bowrango/ising-machine-app/hardware/schematic/sync-ground-bounce-scope.jpg

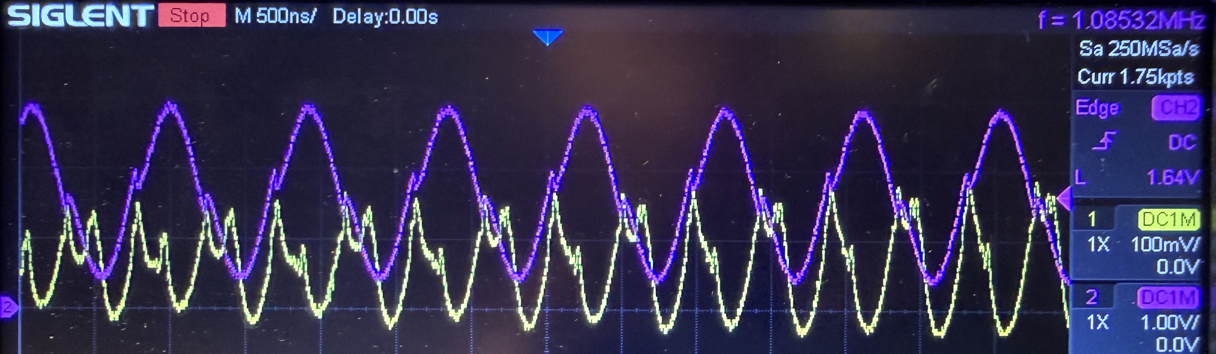
hardware/schematic/sync-ground-bounce-scope.jpg
