bowrango/ising-machine-app/hardware/schematic/software-overview.pdf

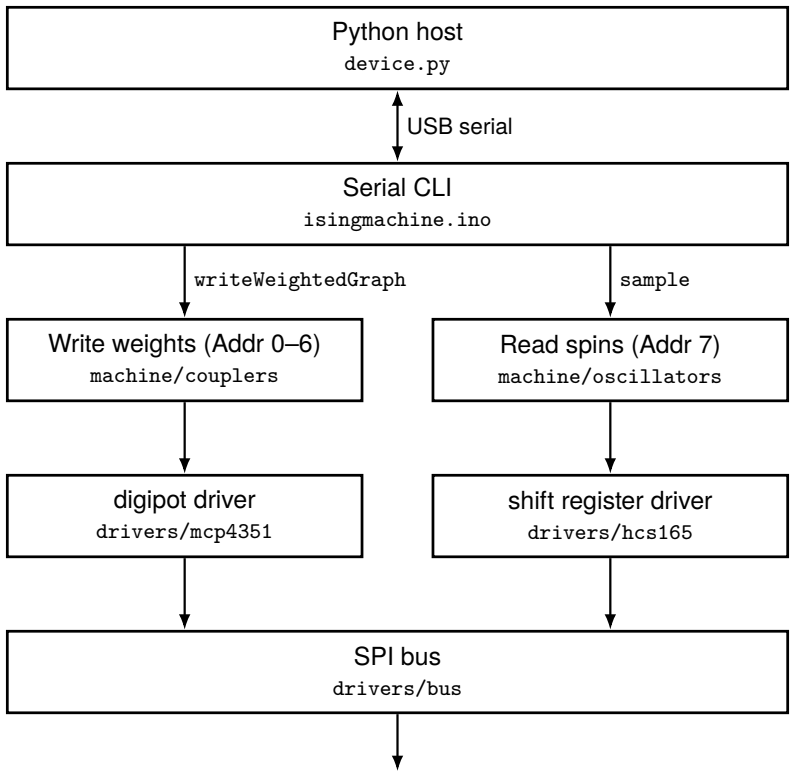
[picture p2: figure]
Python host device.py; Serial CLI isingmachine.ino; USB serial; Write weights (Addr 0–6) machine/couplers; Read spins (Addr 7) machine/oscillators; writeWeightedGraph; sample; digipot driver drivers/mcp4351; shift register driver drivers/hcs165; SPI bus drivers/bus

ADDR, CS1, SH/LD, SCLK, MOSI, MISO
