bowrango/ising-machine-app/hardware/schematic/system-overview.pdf

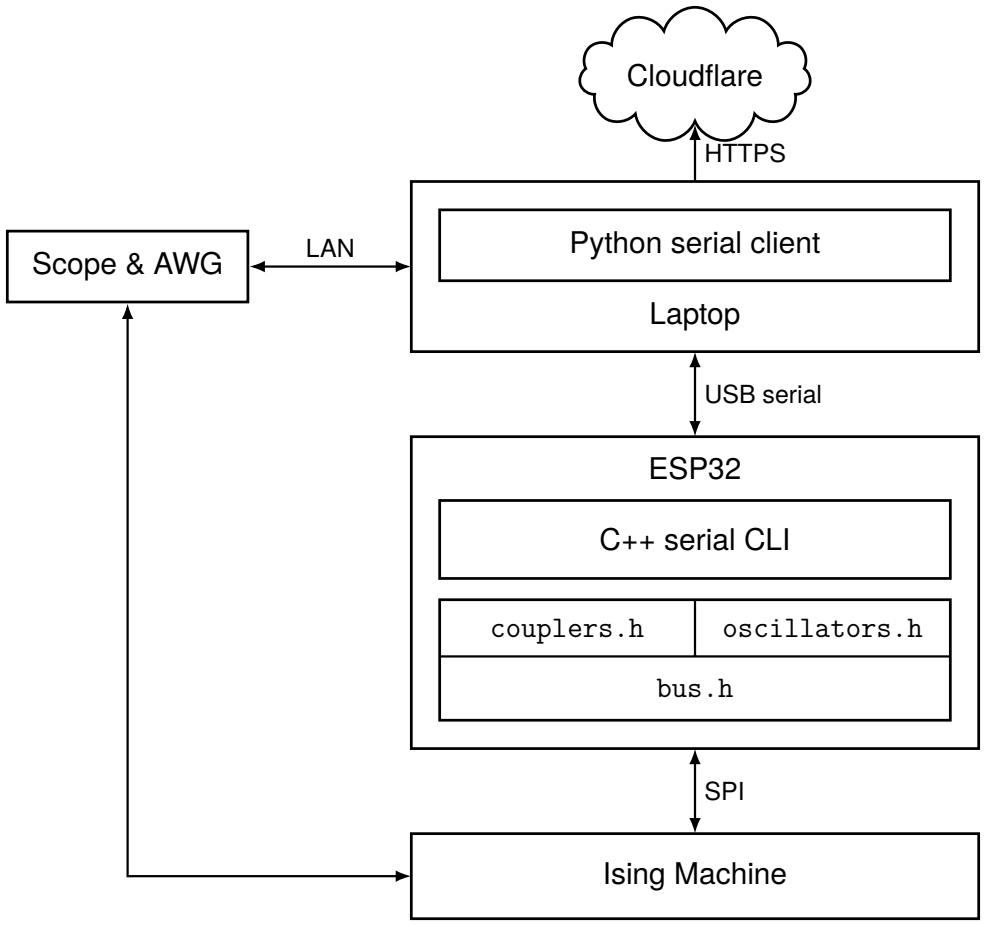
[picture p3: figure]
Cloudflare; Python serial client; Laptop; HTTPS; Scope & AWG; LAN; ESP32; C++ serial CLI; couplers.h; oscillators.h; bus.h; USB serial; Ising Machine; SPI
