bowrango/ising-machine-app/hardware/schematic/cloudflare.pdf

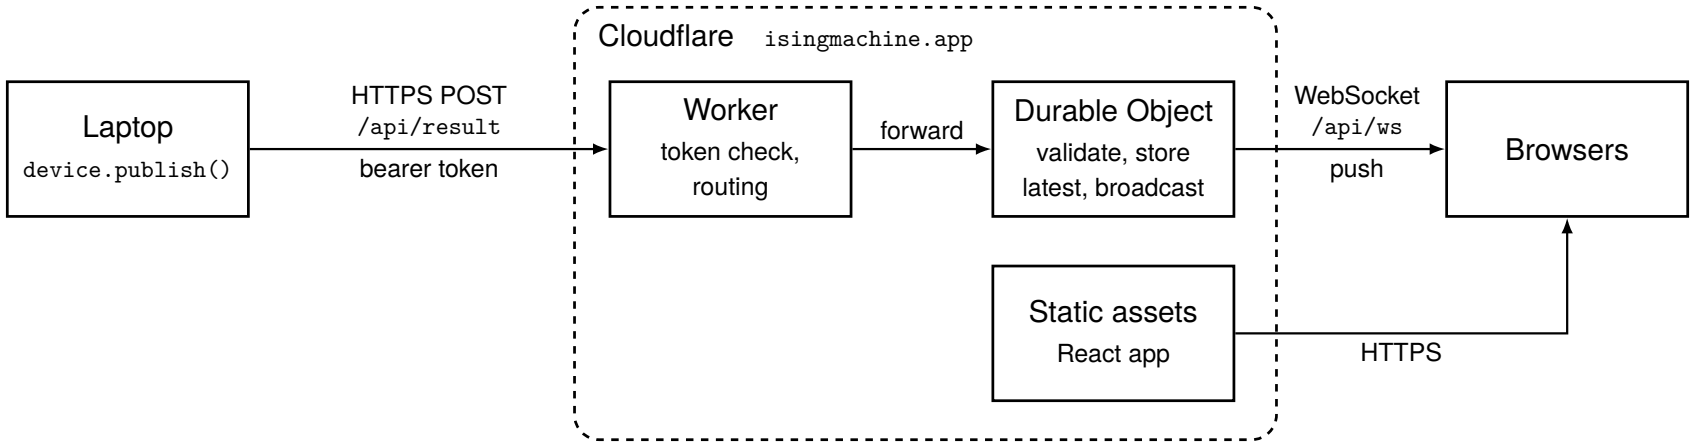
[picture p4: figure]
Cloudflare isingmachine.app; Laptop device.publish(); Worker token check, routing; Durable Object validate, store latest, broadcast; Static assets React app; Browsers; HTTPS POST /api/result bearer token; forward; WebSocket /api/ws push; HTTPS
