bowrango/ising-machine-app/hardware/schematic/spi-bus.pdf

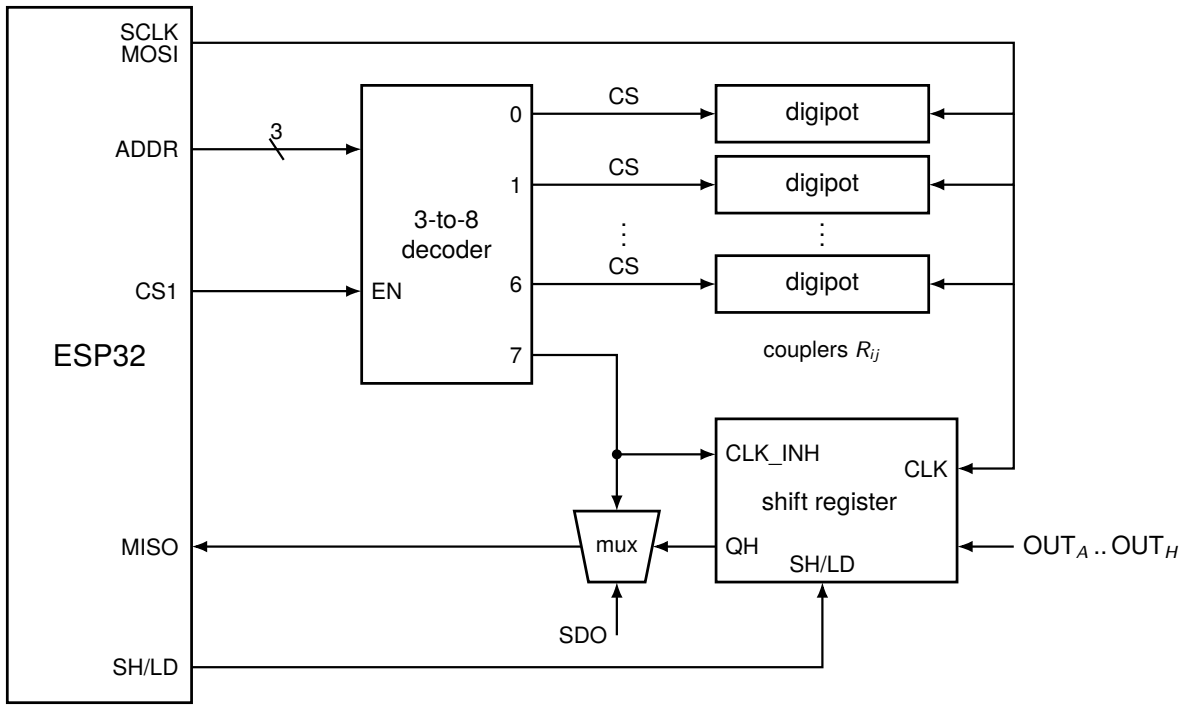
[picture p5: figure]
ESP32; SCLK MOSI; ADDR; MISO; shift register; CLK; 3-to-8 decoder; digipot; couplers Rij; CLK_INH; OUTA .. OUTH; mux; SDO
