bowrango/ising-machine-app/hardware/schematic/coupling-network.pdf

## Problem matrix

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
QUBO Q ∼ 1/R
8 variables
28 possible terms (no bias)

## Conductance matrix

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
Pattern symmetric about the anti-diagonal Coupled at opposite terminals

## Digipot network

A_L (5) | A_R (6)
B_L (9) | B_R (10)
C_L (11) | C_R (12)
D_L (7) | D_R (8)
E_L (1) | E_R (2)
F_L (13) | F_R (14)
G_L (15) | G_R (16)
H_L (3) | H_R (4)

L R

7 × 4-channel digital potentiometers (10 kΩ, 8-bit) Program Rij (8-bit)
