bowrango/ising-machine-app/hardware/schematic/cloudflare.png

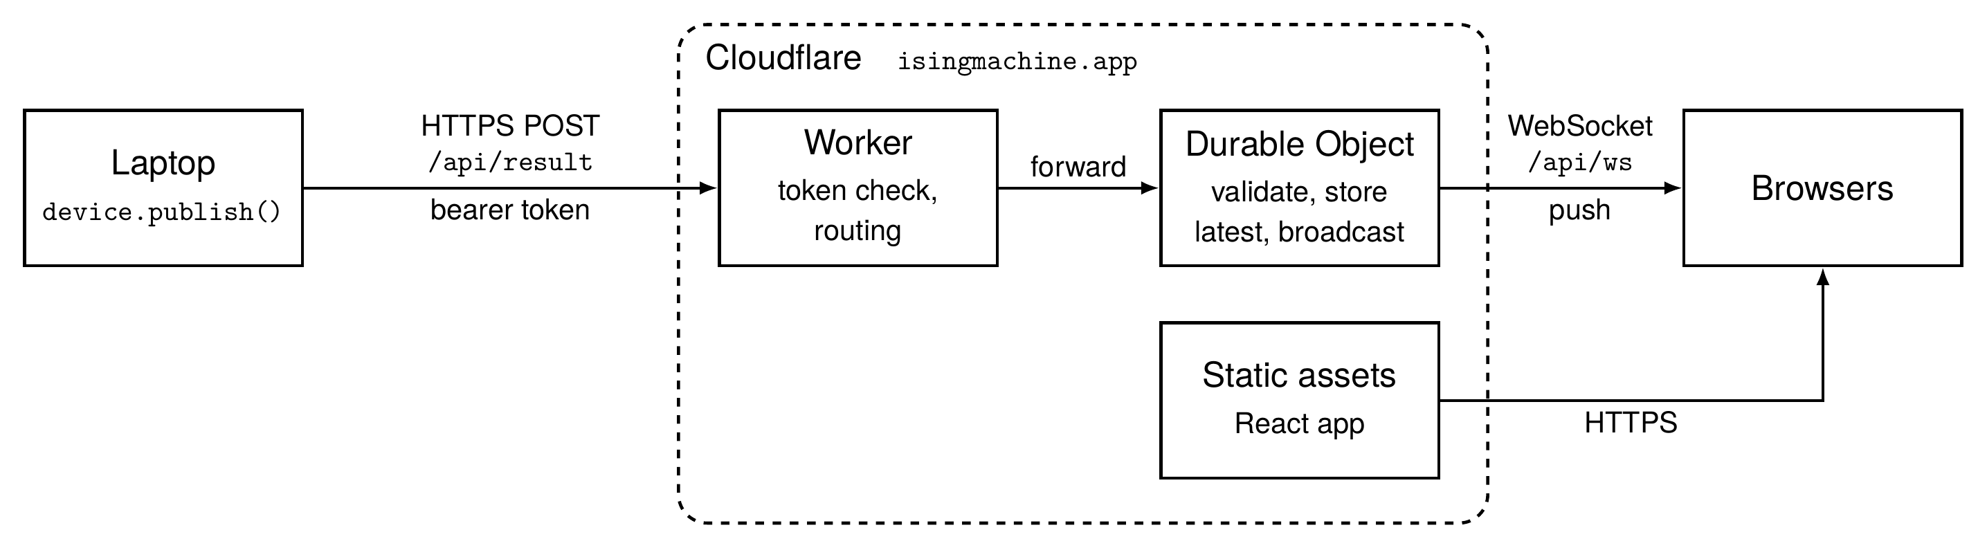
hardware/schematic/cloudflare.png
