bowrango/ising-machine-app/hardware/schematic/coupling-network.png

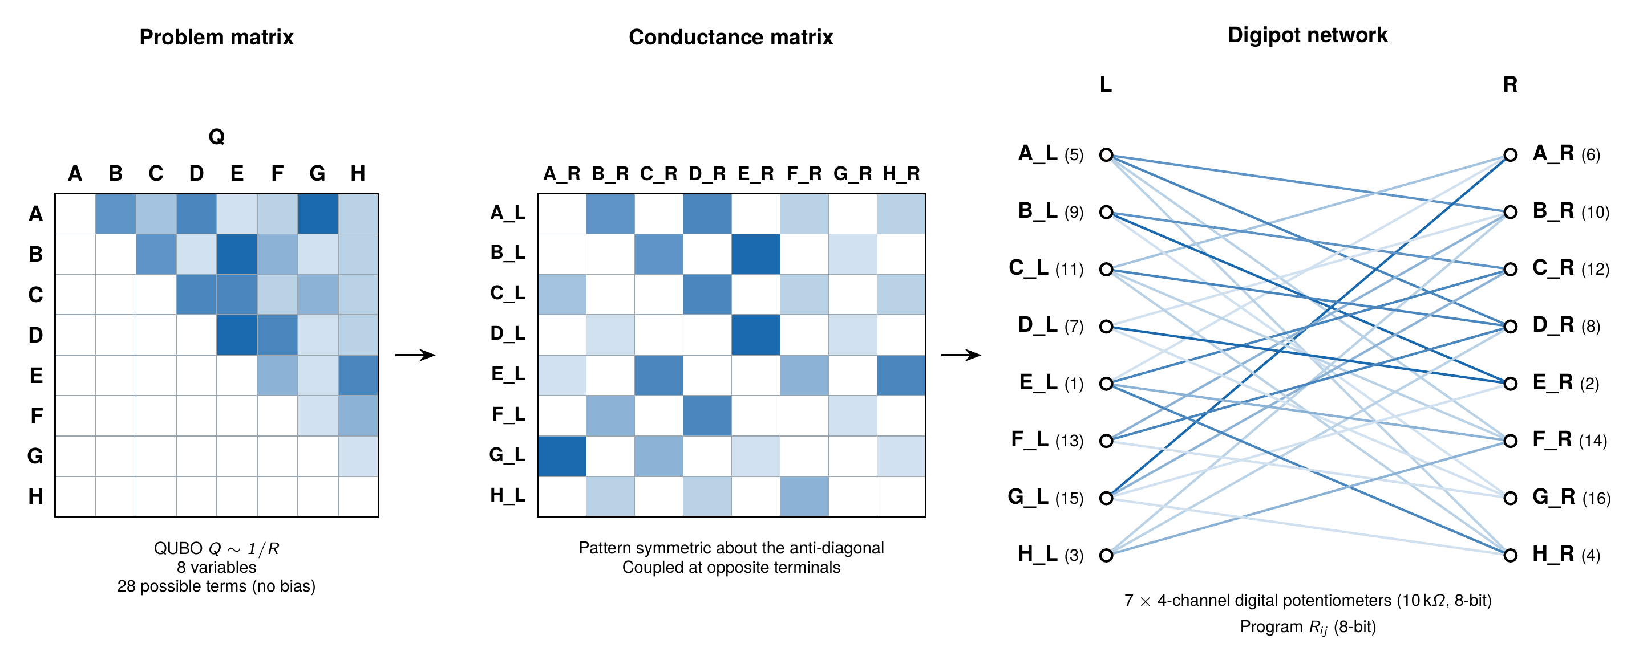
hardware/schematic/coupling-network.png
