bowrango/ising-machine-app/hardware/schematic/oscillator-connection.png

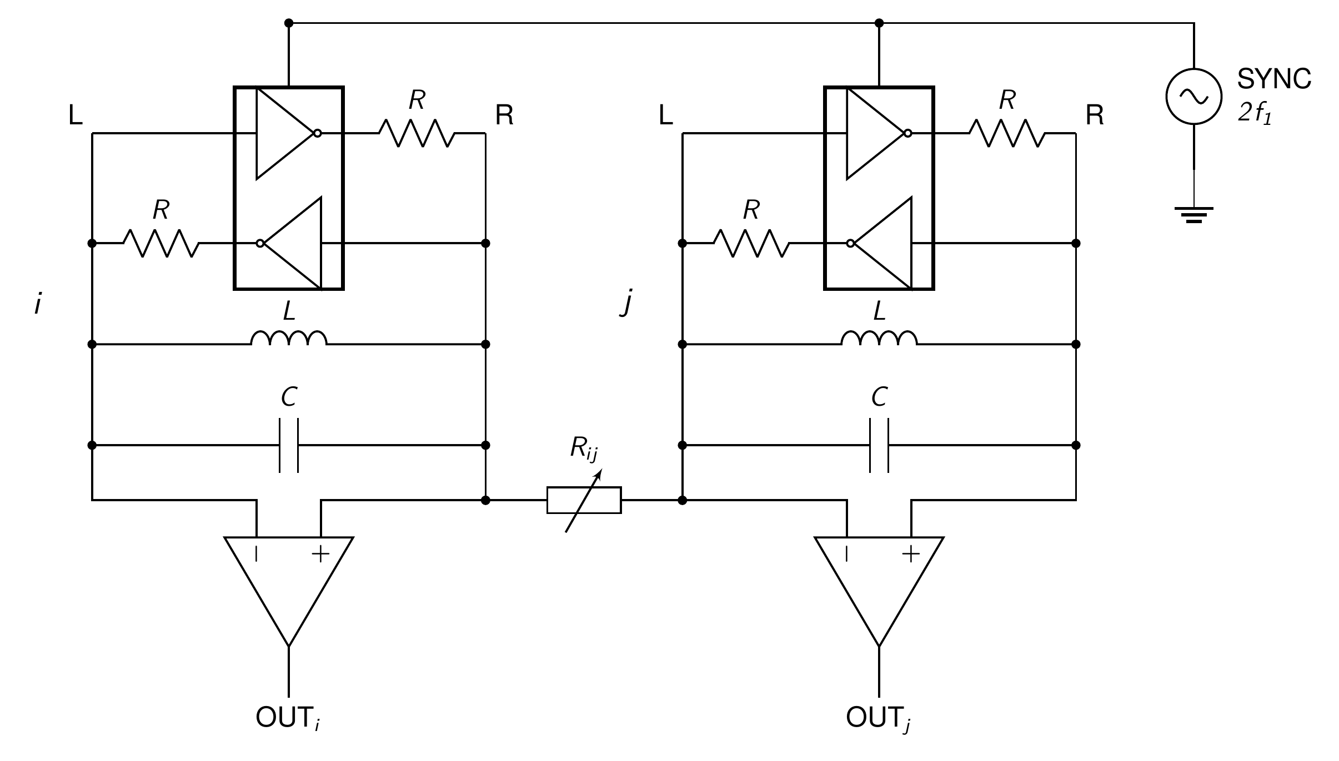
hardware/schematic/oscillator-connection.png
