bowrango/ising-machine-app/hardware/schematic/software-overview.png

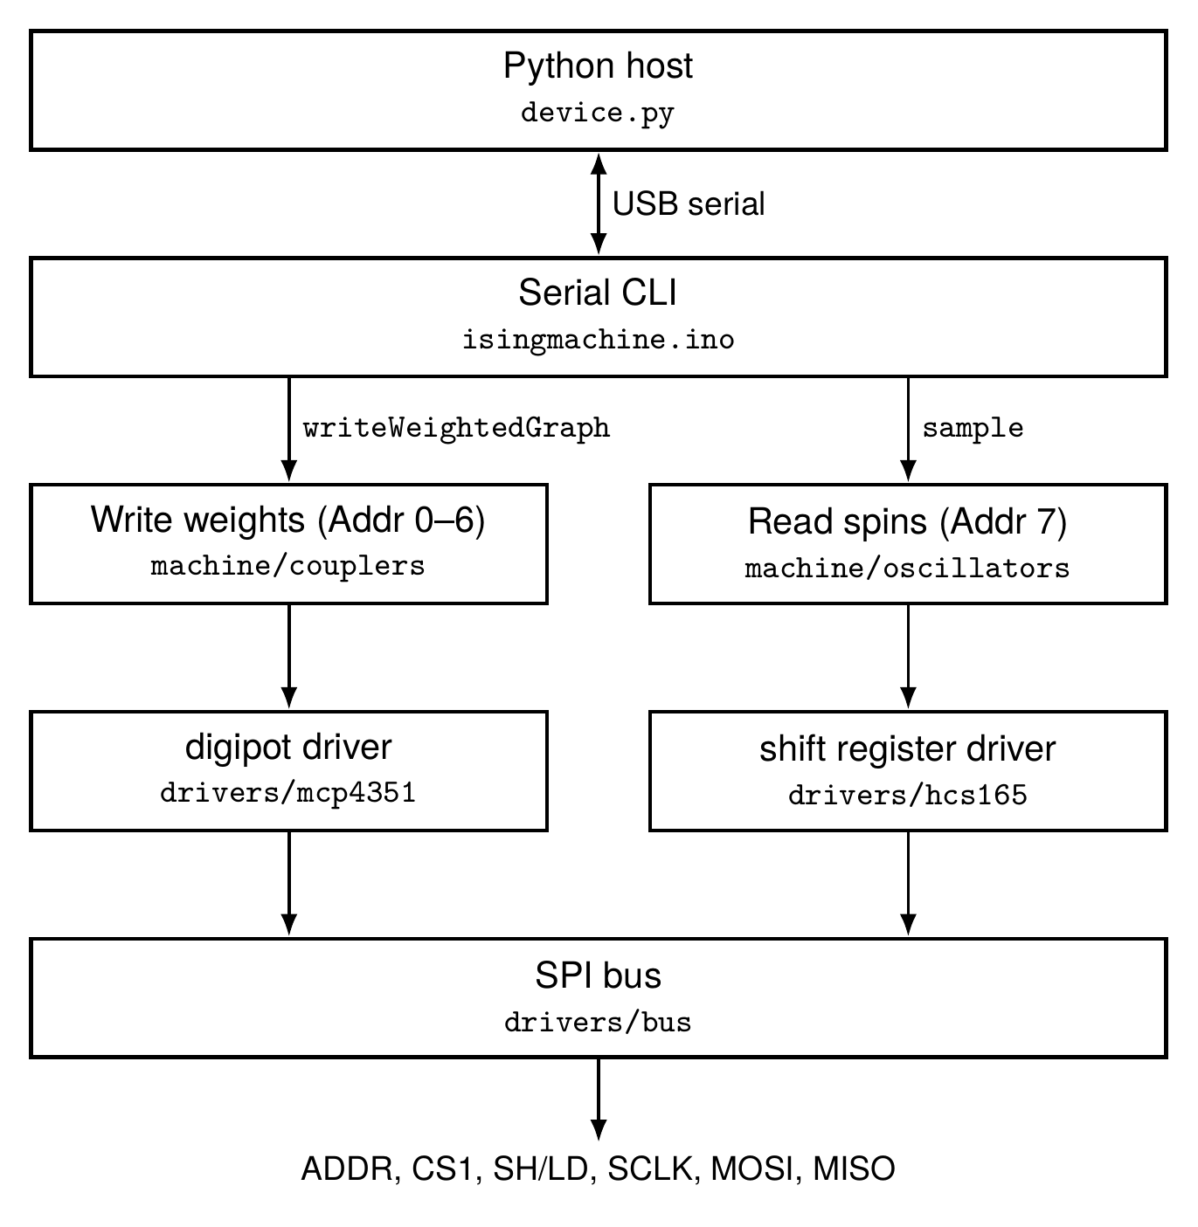
hardware/schematic/software-overview.png
