bowrango/ising-machine-app/hardware/schematic/spi-bus.png

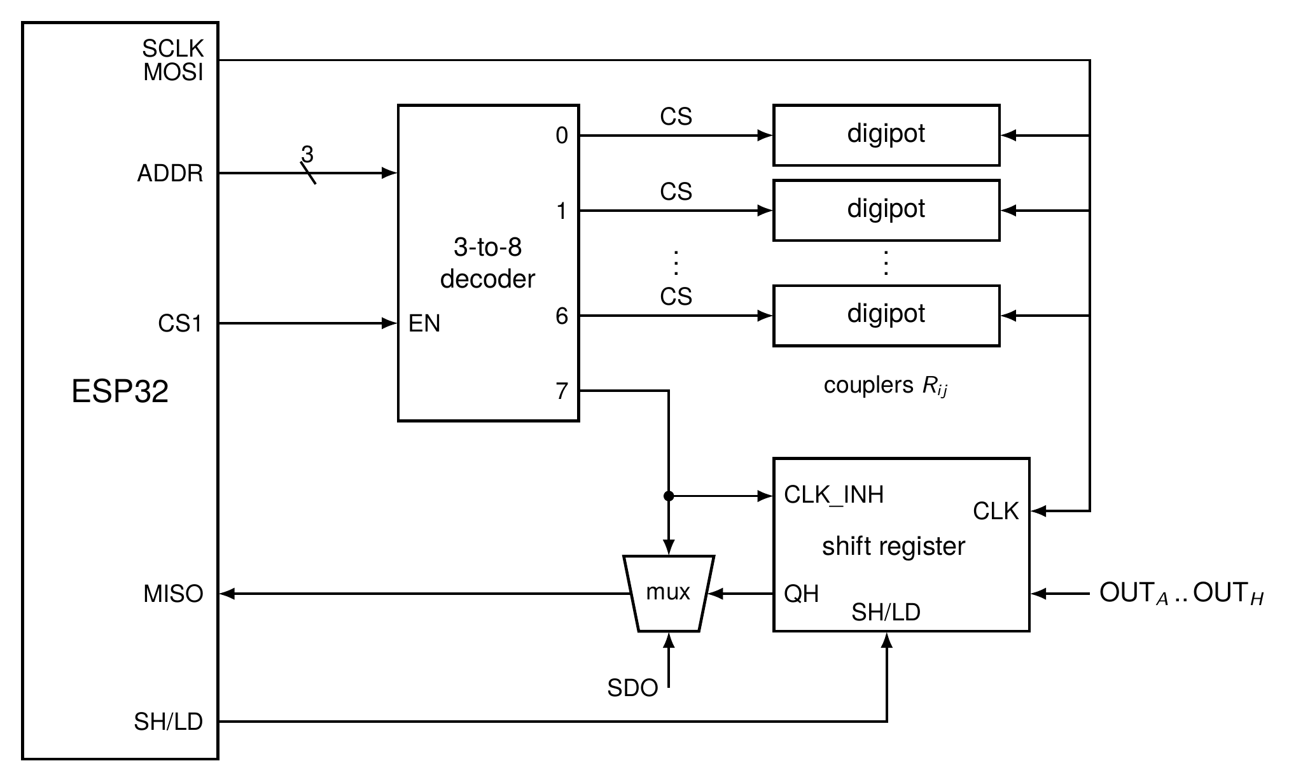
hardware/schematic/spi-bus.png
