bowrango/ising-machine-app/hardware/schematic/sync-ground-bounce.png

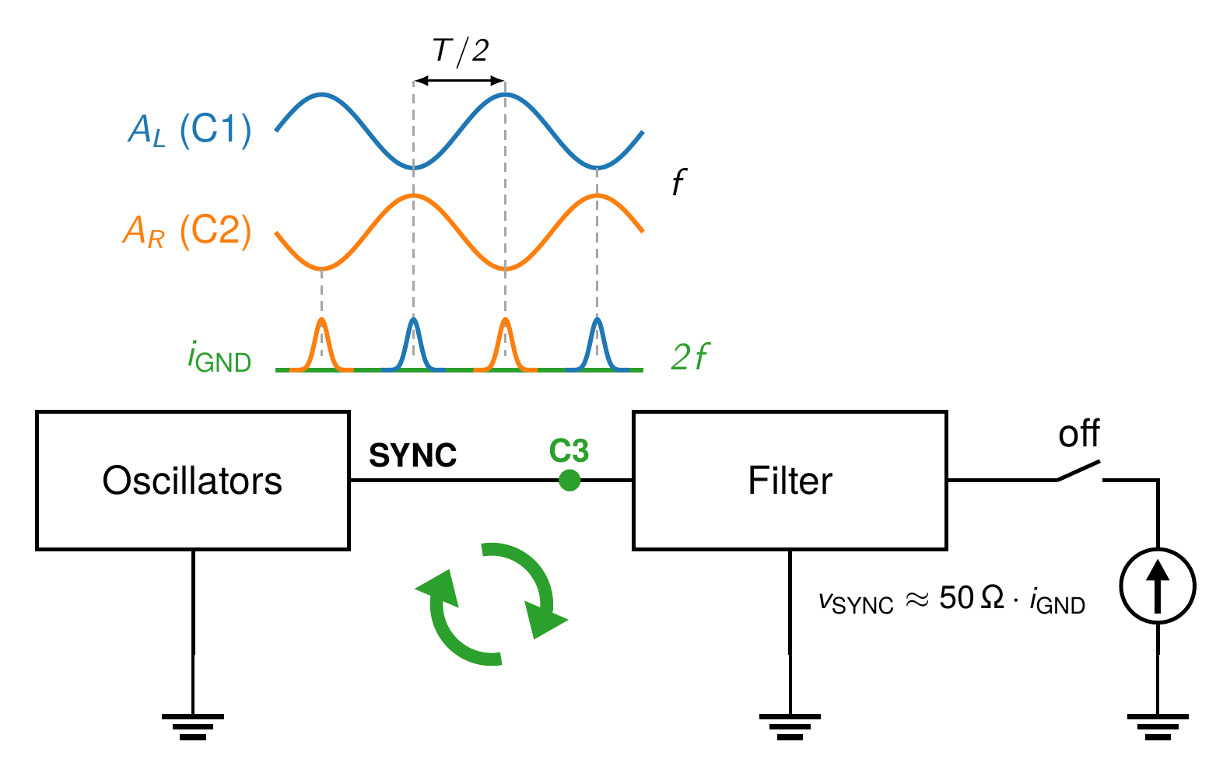
hardware/schematic/sync-ground-bounce.png
