bowrango/ising-machine-app/hardware/schematic/system-overview.png

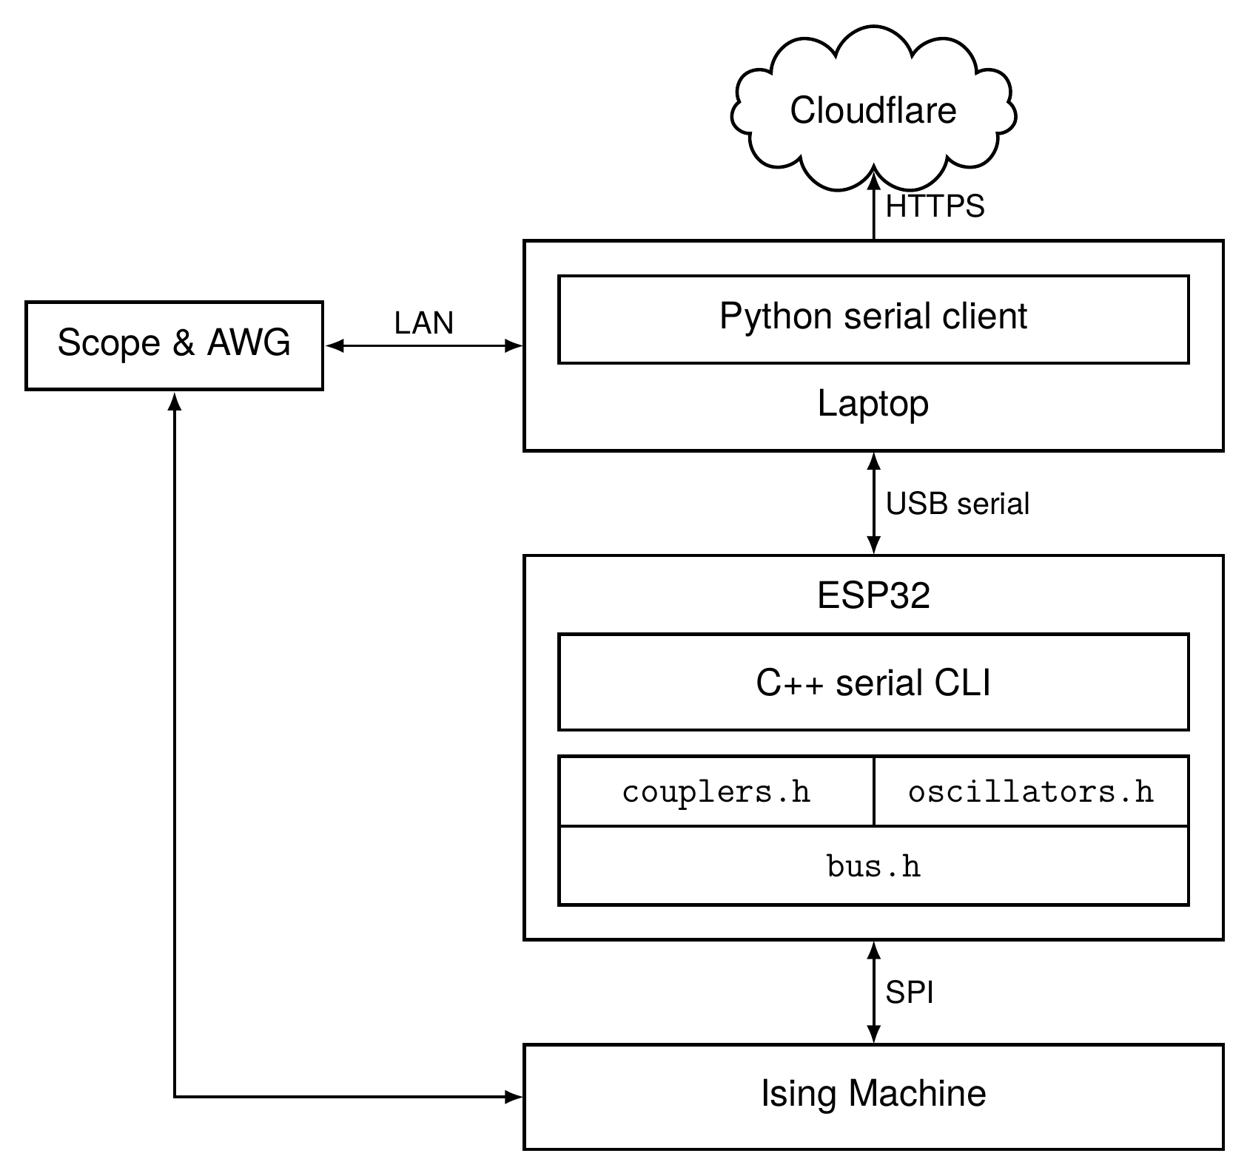
hardware/schematic/system-overview.png
