bowrango/ising-machine-app/hardware/schematic/sync-ground-bounce.pdf

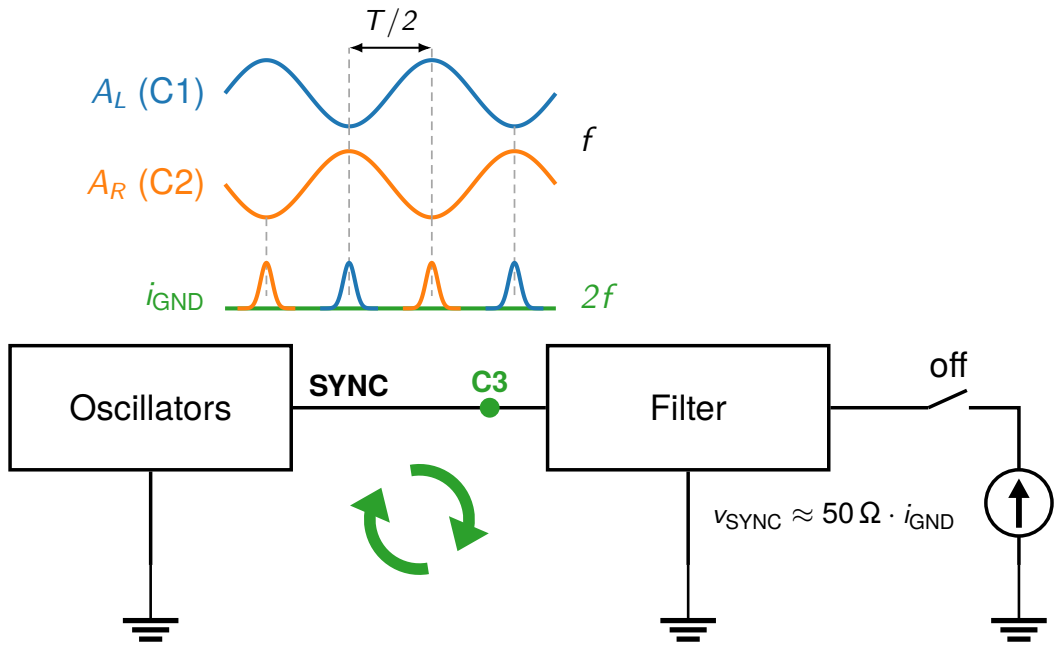
[picture p13: page 1]
Oscillators; Filter SYNC; vSYNC ≈ 50 Ω · iGND; off; iGND
