bowrango/ising-machine-app/hardware/schematic/coupler-schematic.PDF

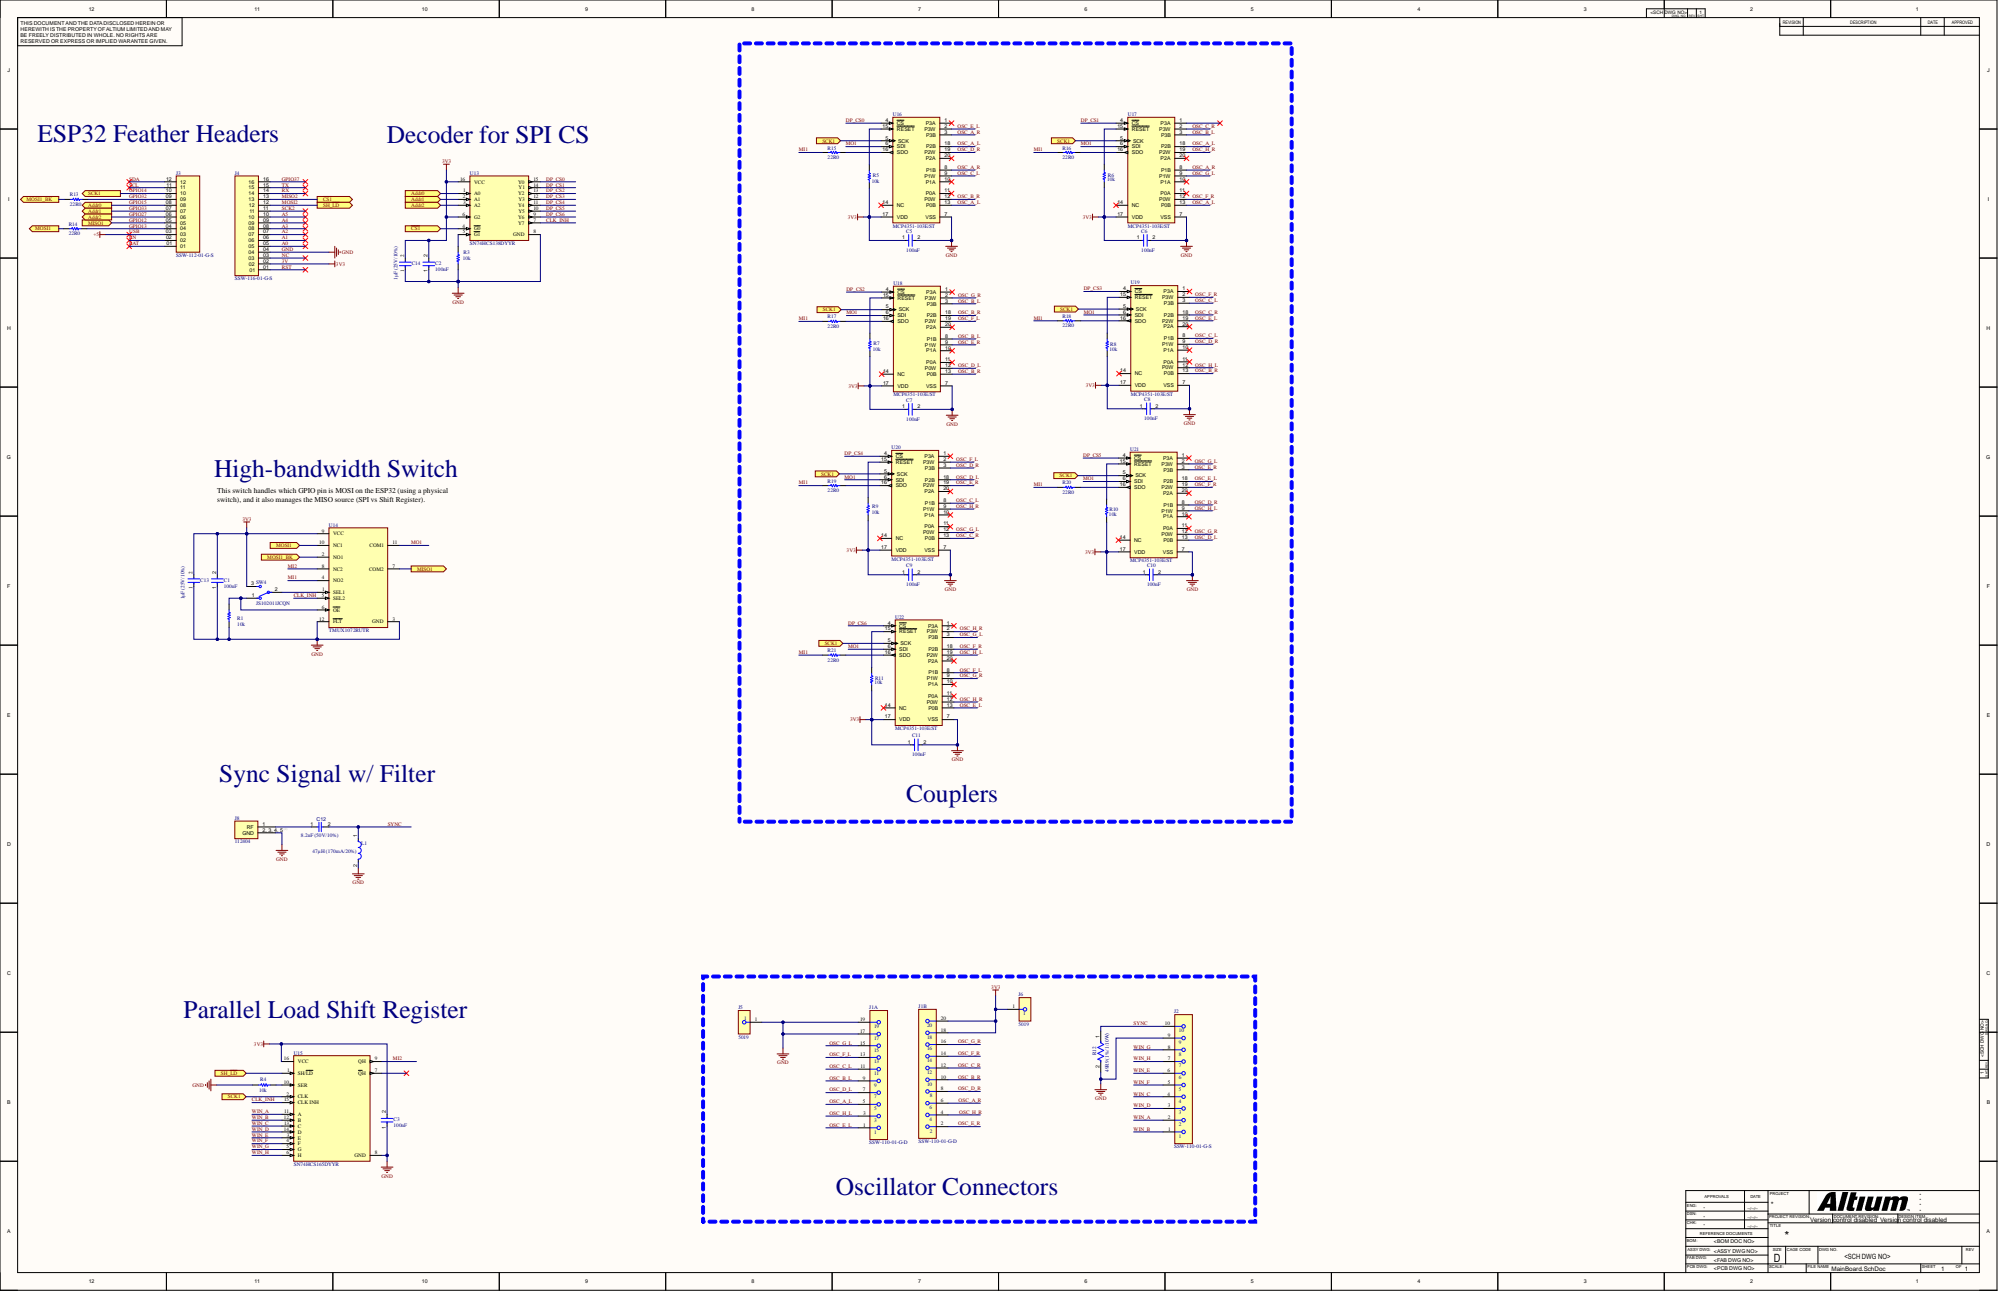
[picture p14: page 1]

<SCH DWG NO> | DWG. NO. | REV. | 1 SHT.

THIS DOCUMENT AND THE DATA DISCLOSED HEREIN OR HEREWITH IS THE PROPERTY OF ALTIUM LIMITED AND MAY BE FREELY DISTRIBUTED IN WHOLE. NO RIGHTS ARE RESERVED OR EXPRESS OR IMPLIED WARANTEE GIVEN. | U16 U17 | REVISION | DESCRIPTION | DATE | APPROVED

This switch handles which GPIO pin is MOSI on the ESP32 (using a physical
switch), and it also manages the MISO source (SPI vs Shift Register).

Parallel Load Shift Register

REV. SHT. DWG. NO.

DATE | PROJECT * | * * APPROVALS * *

ENG: * | --/--/--

DSN: * | --/--/--

CHK: * | --/--/--
