bowrango/ising-machine-app/hardware/schematic/oscillator-schematic.PDF

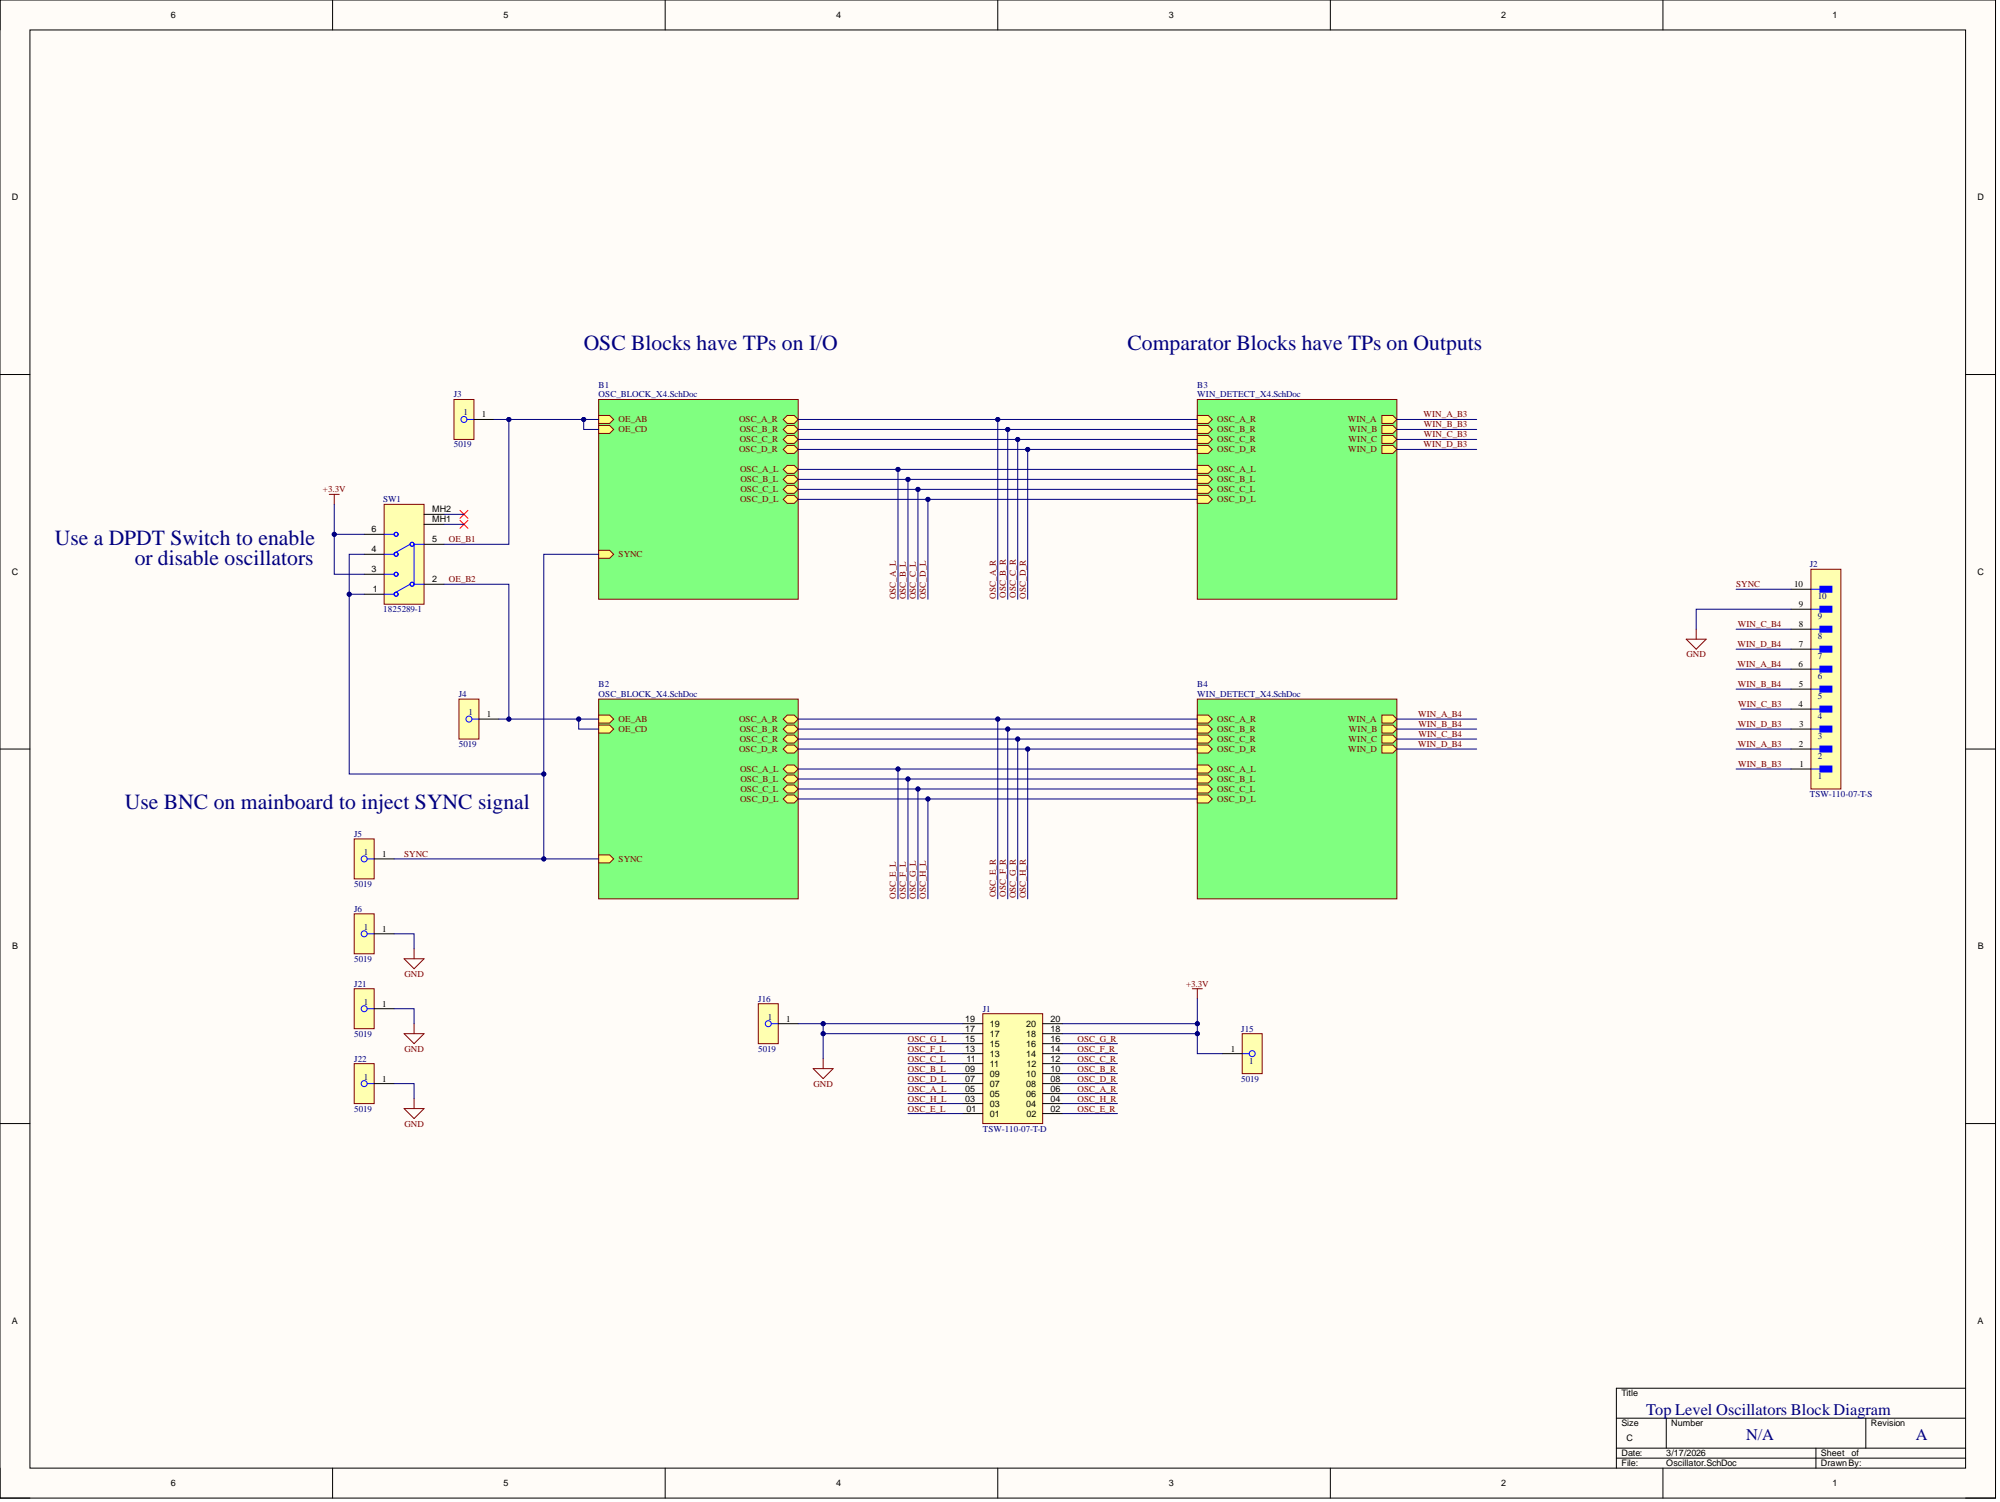
[picture p15: page 1]
Sheet of; Drawn By; B1 OSC_BL; B3 WIN; B4 WIN; B2 OSC_BL

OSC Blocks have TPs on I/O

Comparator Blocks have TPs on Outputs

Use a DPDT Switch to enable

or disable oscillators

Use BNC on mainboard to inject SYNC signal

p Level Oscillators Block Diagram

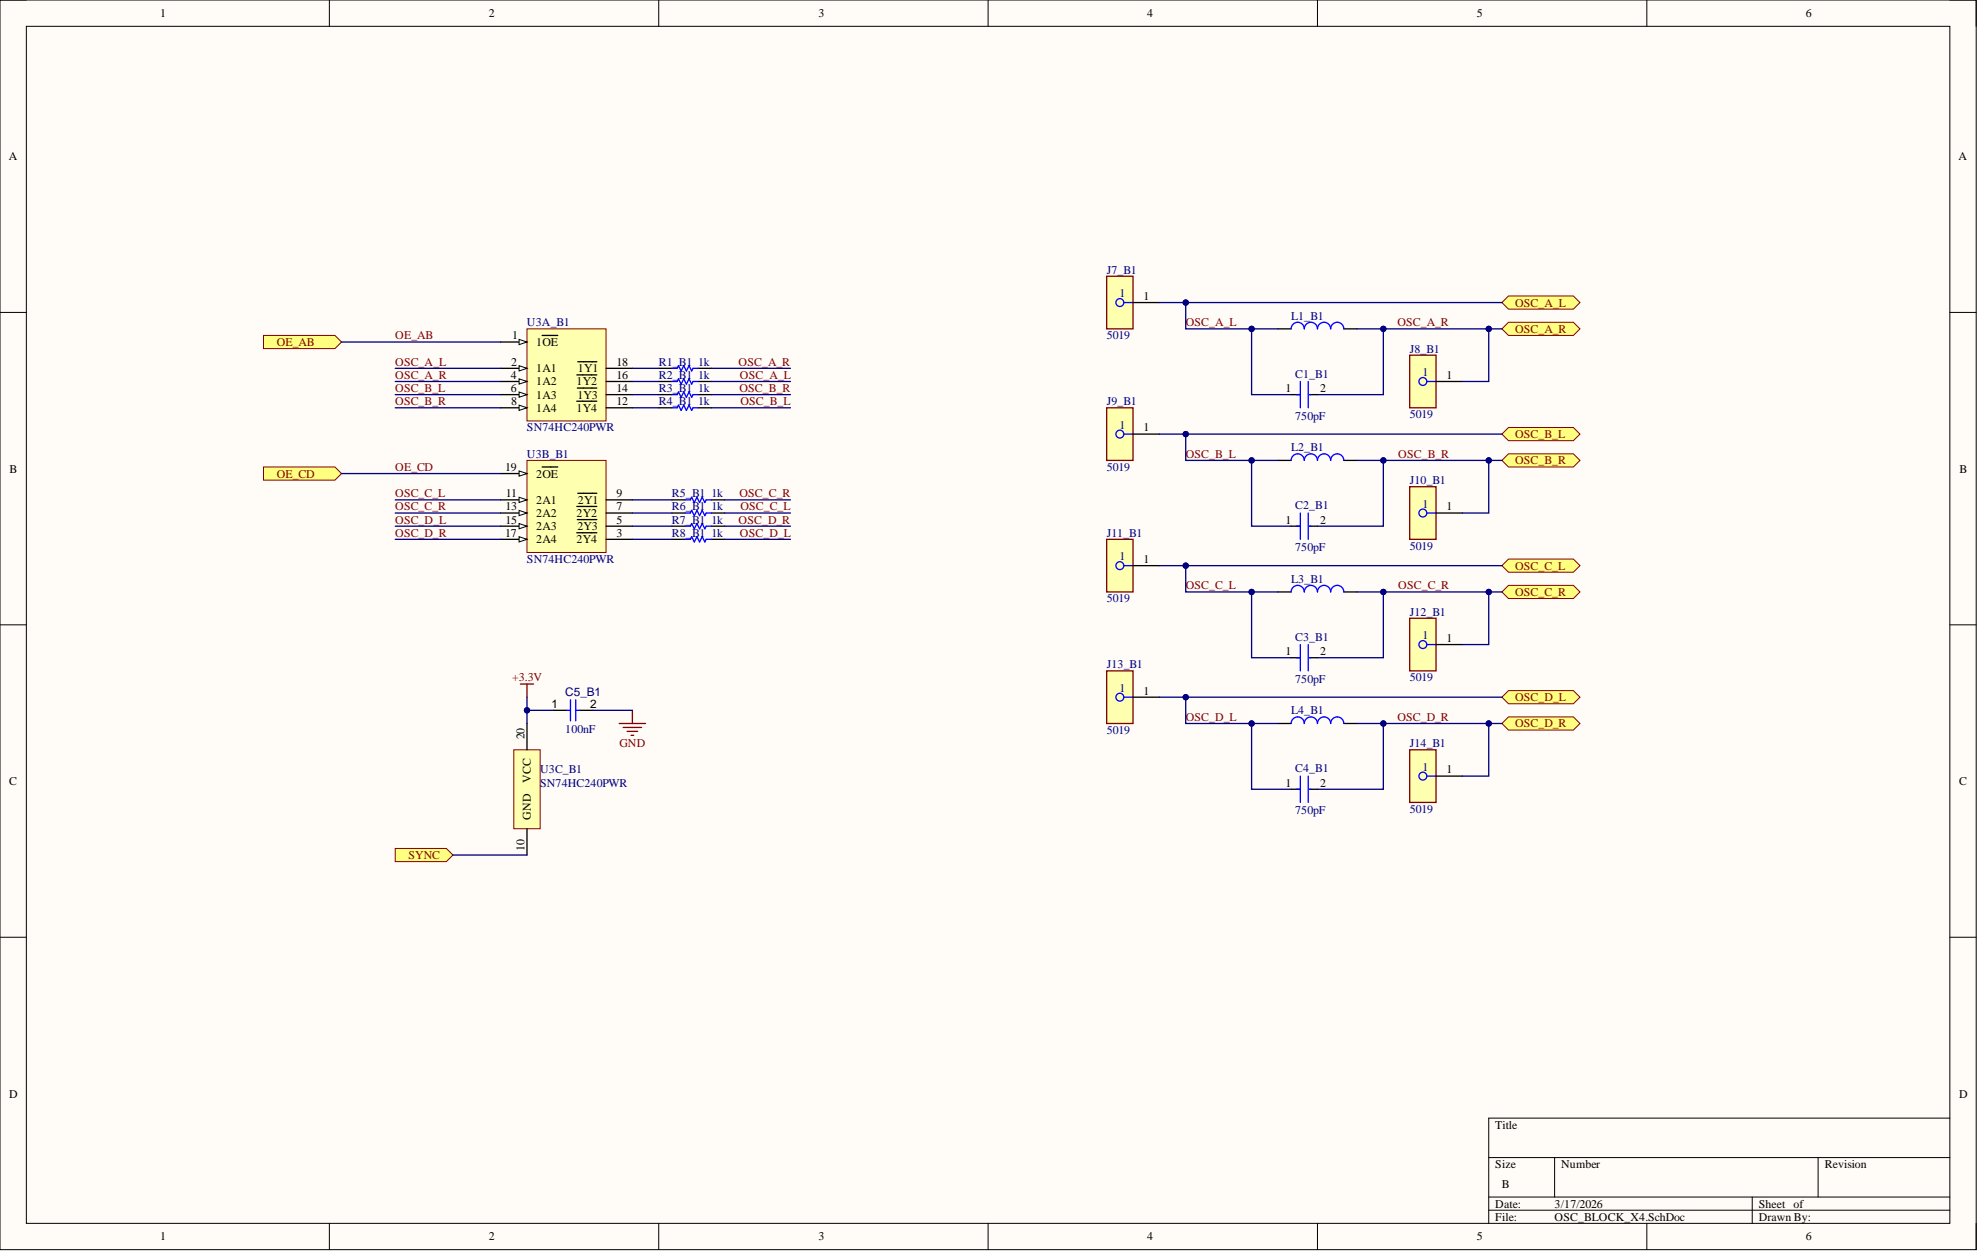
[picture p16: page 2]
Date:; Sheet of; File:; OSC_BLOCK_X4.SchDoc; Drawn By:; GND 10 VCC 20

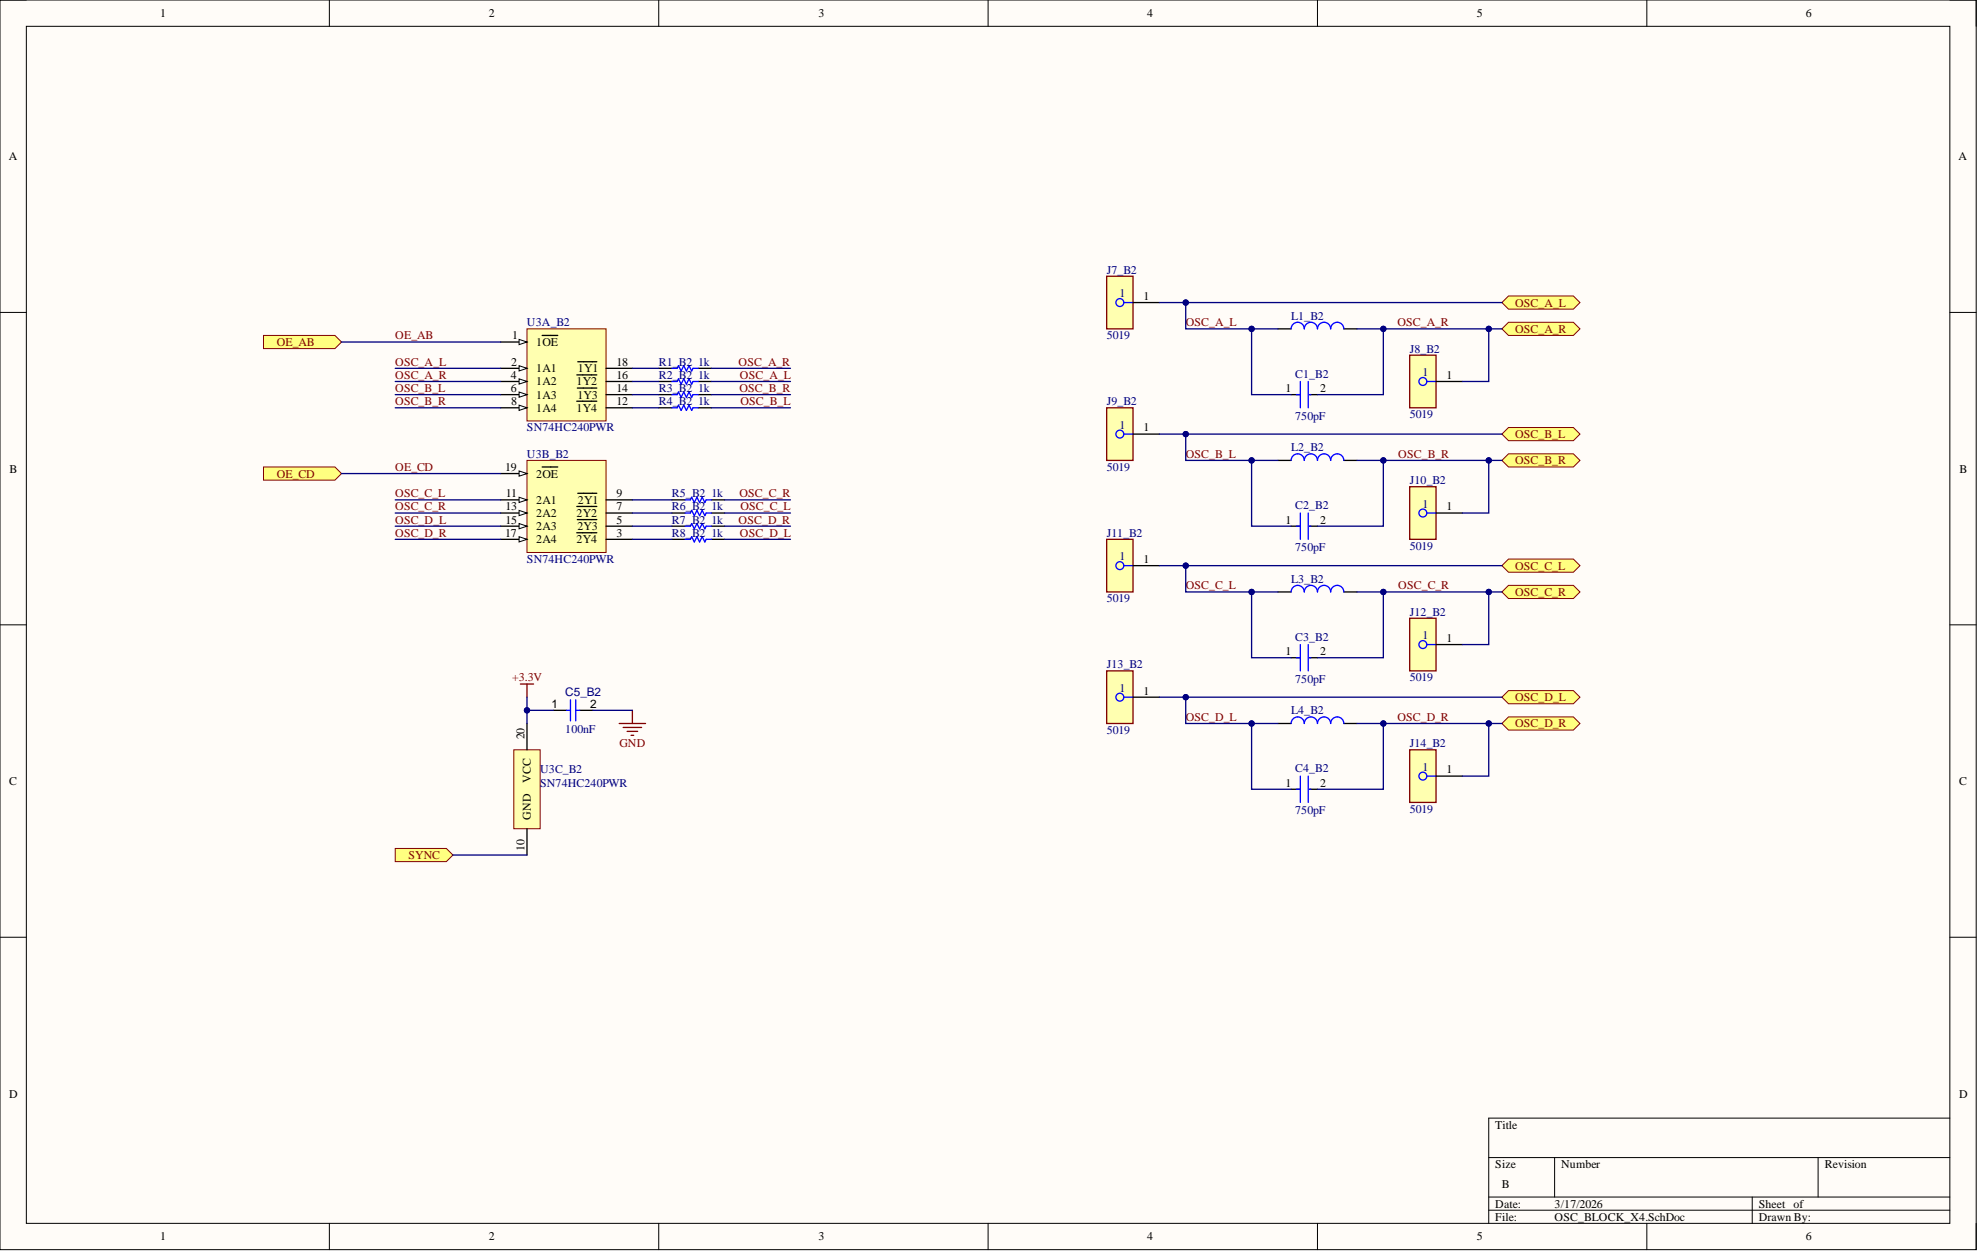
[picture p17: page 3]

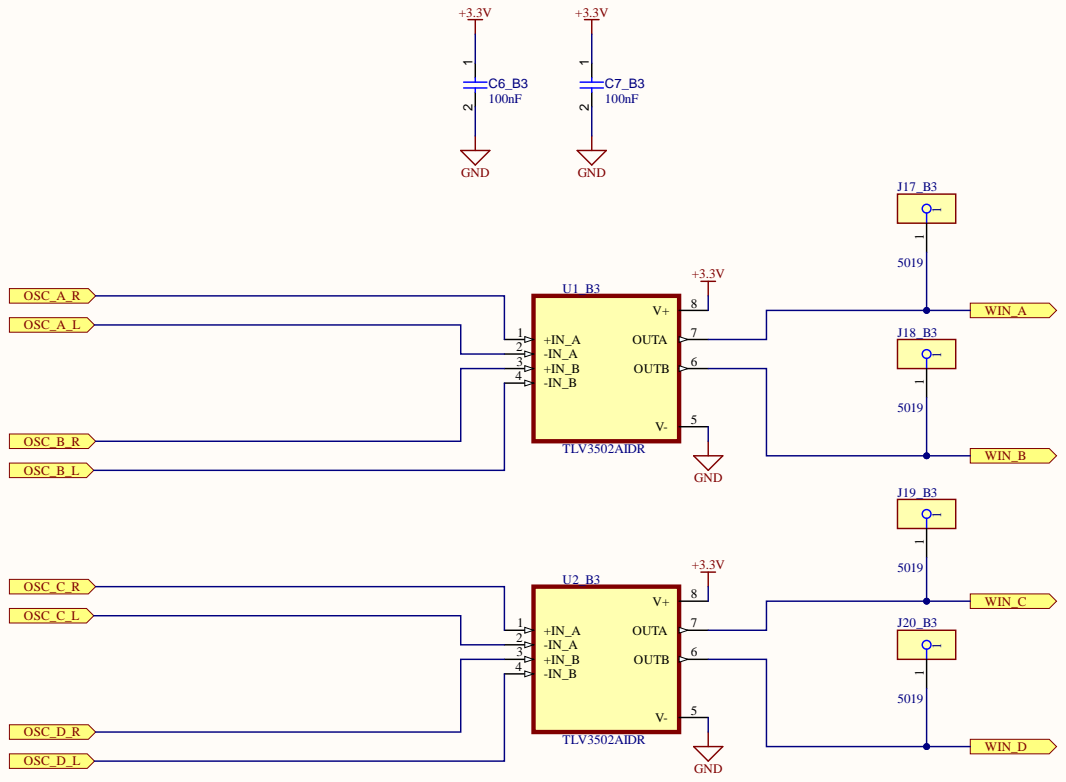
[picture p18: page 4]
Date:; Sheet of; File:; WIN_DETECT_X4.SchDoc; Drawn By:

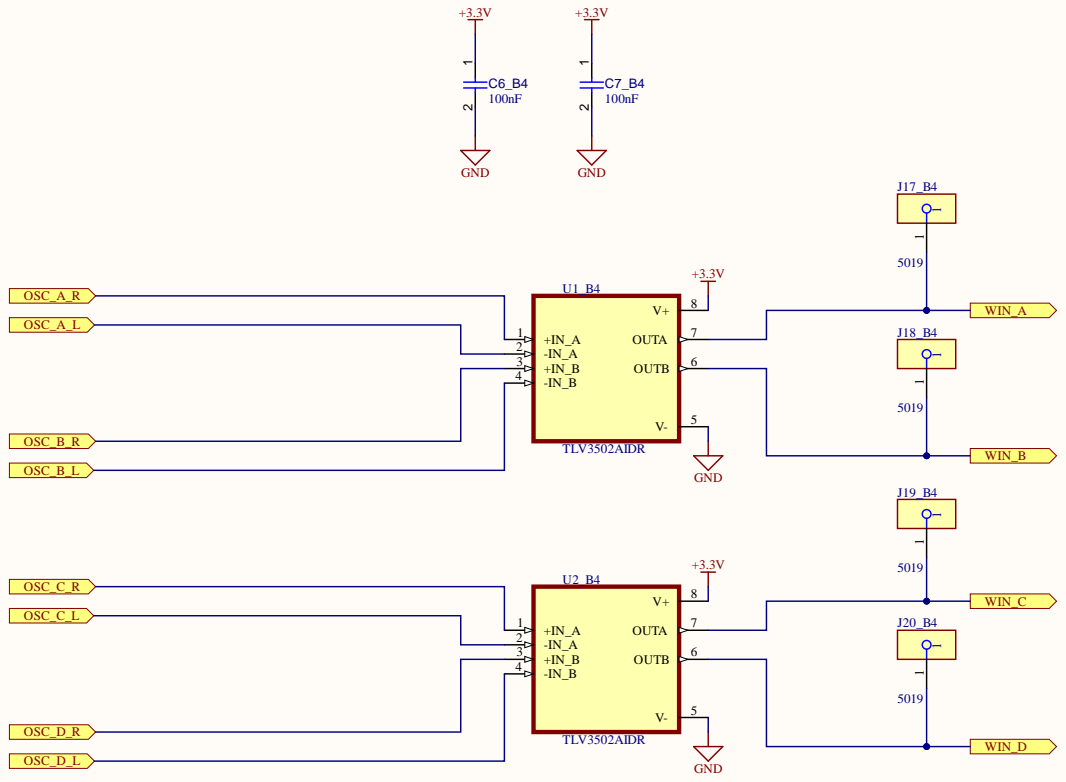
[picture p19: page 5]
