bowrango/ising-machine-app/hardware/schematic/oscillator-connection.pdf

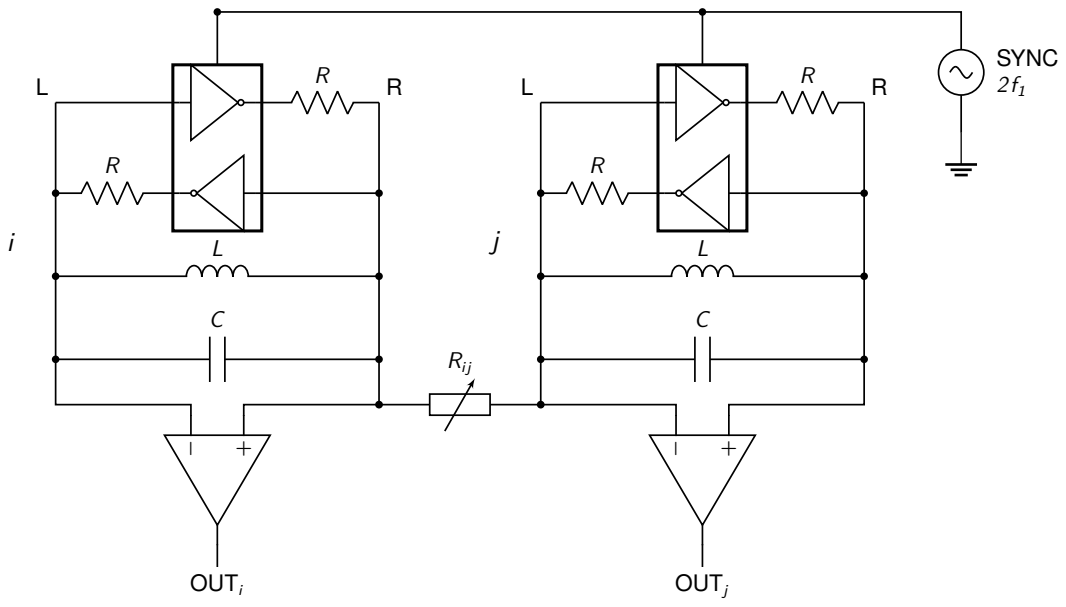
[picture p20: page 1]
OUTi; OUTj; SYNC; Rij
