bowrango/ising-machine-app/hardware/sim/device4.asc

C12: cap; 8.2n
Ccoupler: cap; 3µ
Cosc: cap; 600n
Csync: cap; {Csync}
L12: ind; 47µ
Lsup: ind; {Lsup}
R12: res; 49.9
RAB: res; {Rc(codeAB)}
RAC: res; {Rc(codeAC)}
RAD: res; {Rc(codeAD)}
RBC: res; {Rc(codeBC)}
RBD: res; {Rc(codeBD)}
RCD: res; {Rc(codeCD)}
Rj8: res; {Rj8}
Rsup: res; {Rsup}
Vreg: voltage; {Vcc}
XA: osc; Ct={CtA}
XB: osc; Ct={CtB}
XC: osc; Ct={CtC}
XD: osc; Ct={CtD}
Named nets: a_l, a_r, vcc, g, b_l, b_r, c_l, c_r, d_l, d_r, v3, 0, vs, j8
Four coupled oscillators A-D: shared SYNC net (g) and supply, digipot couplers between opposite terminals.
XA-XD: subcircuit osc (osc.lib), one oscillator each with a 10x probe on _L. Ct fits each one's free-running frequency on the bench (A 1.0521, B 1.0333, C 1.0082, D 1.0081 MHz; 10x probes, no couplers).
Couplers: MCP4351 W-B rheostats, Rc(code) = Rwiper + code/256 Rpot; code < 0 is disconnected. Wiring (coupling-network.tex): j - i odd joins i_L to j_R, even joins i_R to j_L, so every coupler is antiferromagnetic.
Default graph: ring4b (AB, BC, CD, DA at code 0). Plot the phases with: python ../io/ltspice.py device4.raw --phase a b c d
g and supply: shared by all four, as in oscillator.asc (the board's other four oscillators E-H are not modelled).
.include osc.lib
.func Rc(code) {if(code<0,1T,Rwiper+code/256*Rpot)}
.param codeAB=-1 codeBC=-1 codeCD=0 codeAD=-1 codeAC=-1 codeBD=0 Rwiper=75 Rpot=10k
.param CtA=705p CtB=732p CtC=773p CtD=774p
.param Lt=29.95u Q=40 Rs=1k Rout=60 Vcc=3.3 gain=30 td=40n Ton=5u Rloss=4k
.param Chc=3p Cwin=2p Cpot=10p Cprobe=12p Csync=100p Rj8=1G Rsup=0.1 Lsup=100n
.tran 0 300u 0 2n
.save V(a_l) V(a_r) V(b_l) V(b_r) V(c_l) V(c_r) V(d_l) V(d_r) V(g) V(vcc)
.meas tran gpp pp V(g) from 250u to 300u
