bowrango/ising-machine-app/(commit log)

2026-10-09 set eFuse flash at 3.3V to fix boot/upload, fix, command bit offsets, organize firmware
    [board.h, bus.cpp, bus.h, decoder_sweep.cpp, hcs165.cpp, hcs165.h, isingmachine.ino, mcp4351.cpp]
2026-10-12 move coupling_map.h into board.h, increase SPI clock
2026-10-19 remove fake device
2026-10-20 move schematics, basic python hardware io
2026-10-20 Make bus handle all low-level SPI, rename bus and shift-register APIs
2026-10-20 cleanup tests (couplers look good), remove outdated tests
2026-10-22 measure power spectrums
2026-10-22 no print
2026-10-31 device interface to serial cli
2026-11-01 remove publish DEVICE_TOKEN
2026-11-01 update READMEs, rename ESP32 to IsingMachine
2026-11-01 speedup device.py
2026-11-06 cleanup oscillators::sample
2026-11-06 Ltspice device4.asc model with osc.lib
2026-11-06 LTspice driver
2026-11-06 add cubic8 preset, print optimal fraction
2026-11-08 cleanup: readback errors, validate web result, remove vite cache, update READMEs
    [board.h, isingmachine.ino, measureCouplers.cpp, utilities.cpp, utilities.h]
